giltal/esp32p4-attendance-kiosk/THIRD_PARTY_NOTICES.md

# Third-party notices

The application code in this repository is licensed under the MIT License (see `LICENSE`).
The following parts keep their own licenses:

| Path | License | Copyright |
|---|---|---|
| `components/espressif__esp_cam_sensor/` | Apache-2.0 (see its `LICENSE`) | Espressif Systems; OV02C10 driver from Guition's board package |
| `fonts_src/` (Alef) and the bitmap fonts generated from it in `main/fonts/` | SIL Open Font License 1.1 (see `fonts_src/OFL.txt`) | HaGilda & Mushon Zer-Aviv |

Components fetched at build time by the ESP-IDF component manager (ESP-IDF, LVGL, esp_lvgl_port,
esp_video, esp_ipa, ESP-DL / human_face_detect / human_face_recognition, esp_hosted, ...) are
distributed under their own licenses.
