giltal/esp32p4-attendance-kiosk/mechanical/BackCover.stl

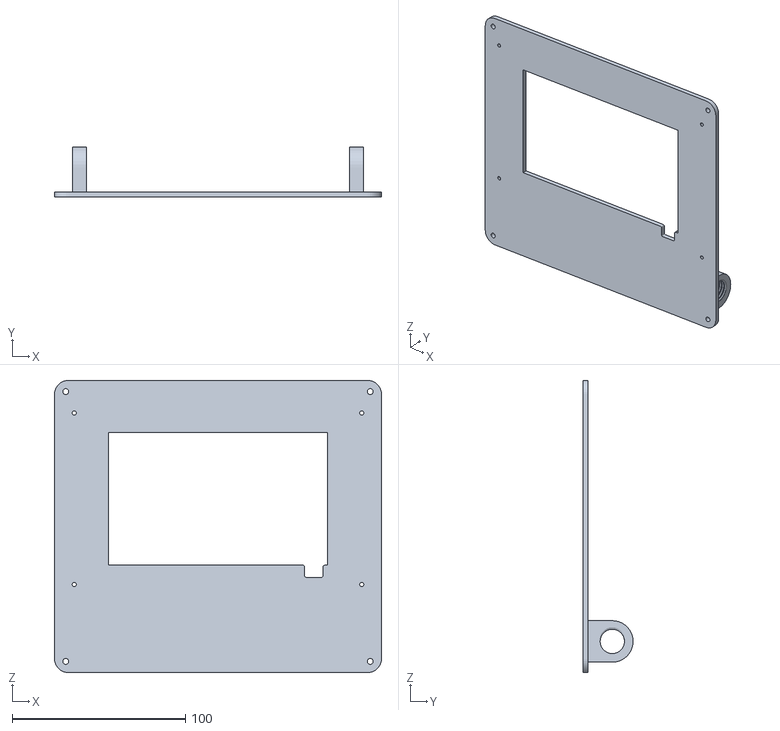
[picture p1: CAD file, 2026-10-18]
mechanical/BackCover.stl
188.8 x 29.0 x 168.7
