giltal/esp32p4-attendance-kiosk/mechanical/WallBracket.stl

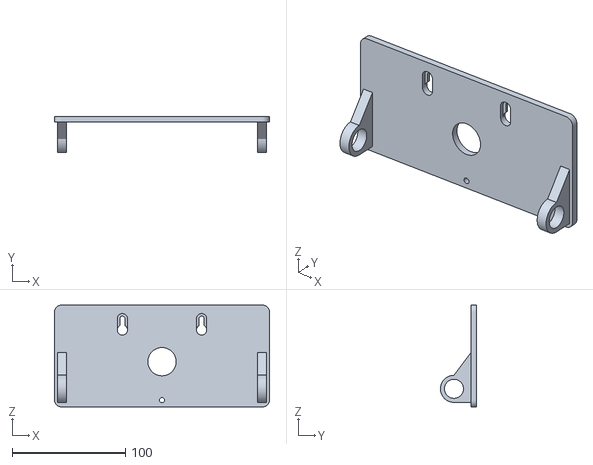
[picture p2: CAD file, 2026-10-18]
mechanical/WallBracket.stl
190.0 x 32.0 x 90.0
