giltal/esp32p4-attendance-kiosk/mechanical/SensorClamp.stl

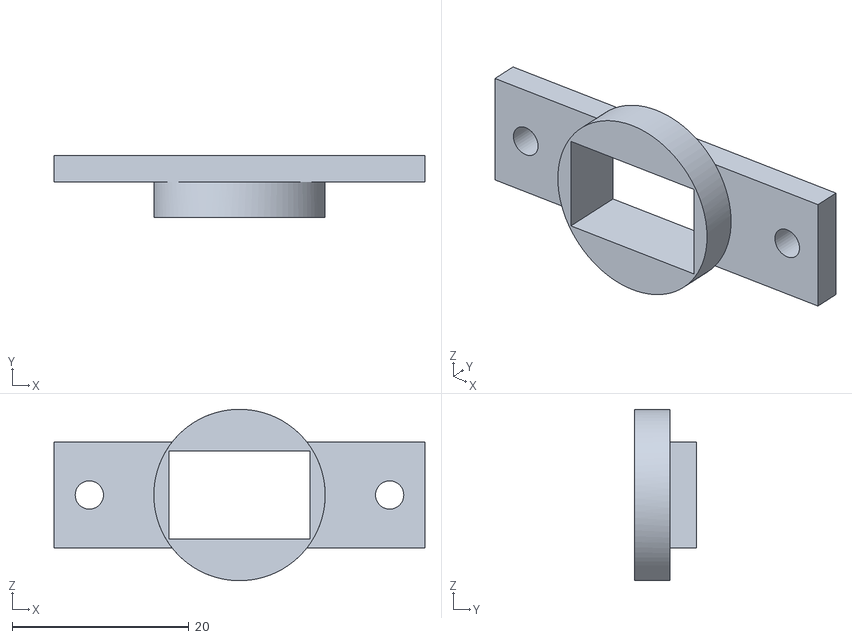
[picture p3: CAD file, 2026-10-18]
mechanical/SensorClamp.stl
42.0 x 7.00 x 19.4
