giltal/esp32p4-attendance-kiosk/mechanical/Housing.stl

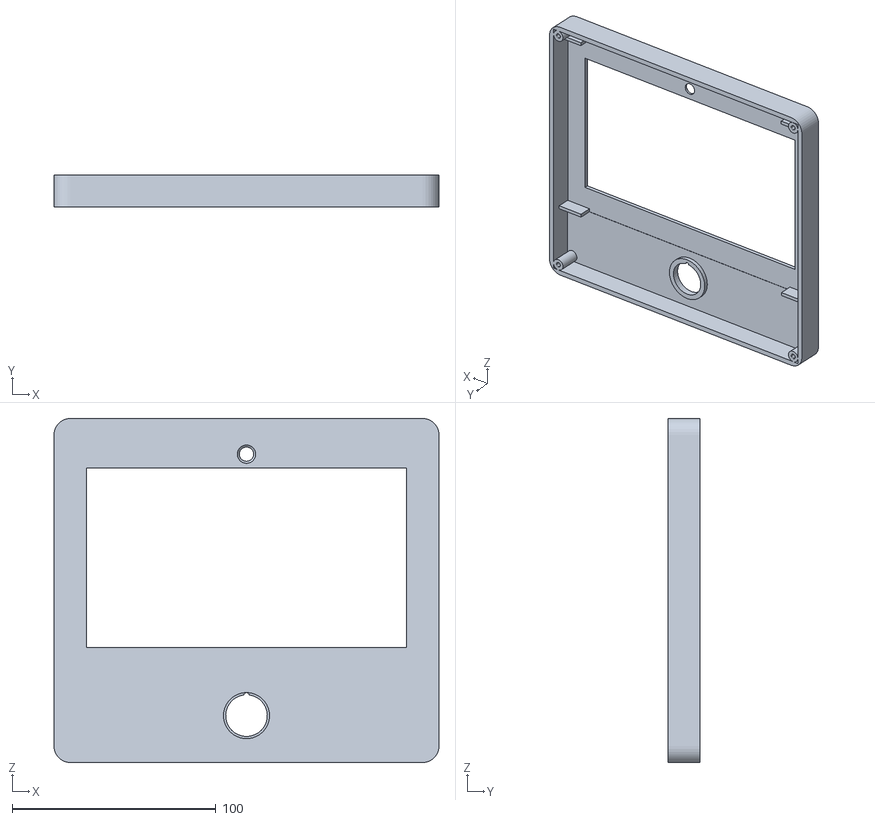
[picture p4: CAD file, 2026-10-18]
mechanical/Housing.stl
188.8 x 15.9 x 168.7
