giltal/esp32p4-attendance-kiosk/mechanical/TiltKnob.stl

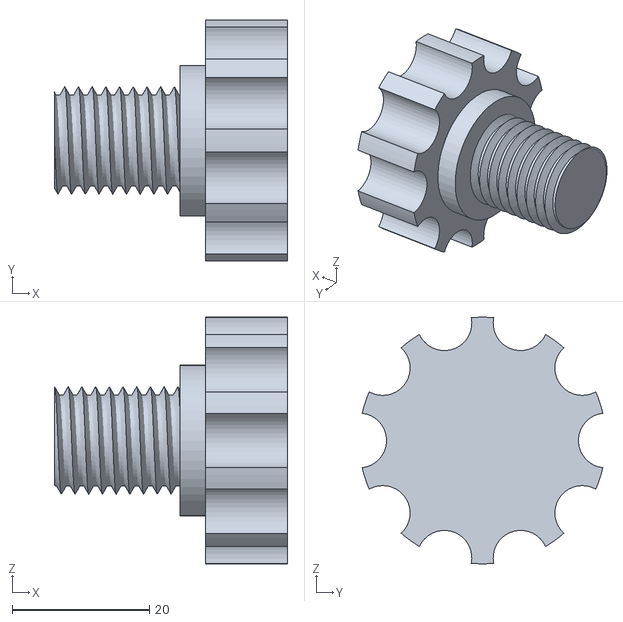
[picture p5: CAD file, 2026-10-18]
mechanical/TiltKnob.stl
34.0 x 35.1 x 36.0
