giltal/esp32p4-attendance-kiosk/(commit log)

2026-10-09 Initial public release: ESP32-P4 attendance kiosk
    Student entry/exit attendance system for the Guition JC1060P470C_I_W_Y
    (ESP32-P4, 7" touch display, OV02C10 camera, SD card, RTC, Wi-Fi via C6):
    face recognition (ESP-DL) and UART fingerprint sensor, Hebrew RTL UI,
    admin screen, daily logs and monthly reports on the SD card.
    Fonts regenerated from Alef (SIL OFL); vendored esp_cam_sensor with the
    OV02C10 driver (Apache-2.0). Application code under the MIT license.
    [partitions.csv]
2026-10-09 Name all reset reasons (USB, JTAG, eFuse, power glitch, CPU lock-up)
    [main.c]
2026-10-15 Fingerprint: GROW protocol driver for the FPM383F (57600, TX=GPIO4/RX=GPIO3)
    Protocol scan diagnostic (GROW / FPM383 / ID809 at 5 bauds x 2 pin orders)
    identified the module; fp_sensor reimplemented on GROW behind the same API.
    Verified: enrollment (3 captures), identification, attendance IN/repeat.
2026-10-15 README: fingerprint section for the FPM383F (GROW, 57600, TX=GPIO4/RX=GPIO3)
2026-10-15 Fingerprint LED: drive the FPM383F ring with the native FPM383 command (02 0F)
    The module ignores GROW AuraLedConfig; it accepts the FPM383-protocol LED
    command on the same UART (breathing / on / blink, G/R/B colour bits).
2026-10-18 Wall-mount enclosure: printable STL parts (housing, back cover, wall bracket, tilt knob, sensor clamp)
    Print-verified on the cased JC1060P470C + FPM383F. Tilt 0-30 deg via two
    printed M16x2 knob screws (print TiltKnob twice).
2026-10-18 v0.2.0: camera mirror setting for the main screen, wall-mount README section
    - "היפוך מראה" (camera tab) now flips the live view on the main screen too and is
    saved in config.txt (mirror=, default 0 = not mirrored); face box follows it
    - README: wall-mount enclosure (parts, printing, hardware, assembly)
    - .gitignore: .mcp.json
